HaroldHallikainen/DSP_TU_PCB/DSP_TU_BOM_C.xlsx

Source: | C:\Users\Harold_Win7\Documents\KiCad\DSP_TU\DSP_TU.kicad_sch
Date: | 2023-05-30 15:31
Tool: | Eeschema 7.0.5
Generator: | C:\Program Files\KiCad\6.0\bin\scripting\plugins/bom_csv_grouped_by_value_with_fp.py
Component Count: | 72 |  |  |  |  | Digikey |  | Mouser
Ref | Qnty | Value | Cmp name | Footprint | Description | p/n | Total Cost | p/n | Total Cost
C1, C2, C3, C4, C5, C6, C7, C8, C12, C13, C18, C22, C23, | 13 | 100nF | C | Capacitor_SMD:C_0603_1608Metric_Pad1.08x0.95mm_HandSolder, 50V X7R | 0.1 µF ±10% 50V Ceramic Capacitor X7R 0603 (1608 Metric) | 1276-1935-1-ND | $0.25 | 581-0603X7R104JT1AT | $5.66
C9, | 1 | 1nF | C | Capacitor_SMD:C_0603_1608Metric_Pad1.08x0.95mm_HandSolder | 1000 pF ±1% 50V Ceramic Capacitor C0G, NP0 0603 (1608 Metric) | 1292-1475-1-ND | $0.10 | 80-C0603C102F4G | $0.82
C10, C19, | 2 | 1uF | C | Capacitor_SMD:C_0603_1608Metric_Pad1.08x0.95mm_HandSolder | 1 µF ±10% 10V Ceramic Capacitor X7R 0603 (1608 Metric) | 1276-1946-1-ND | $0.20 | 581-0603X7R105KT7AT | $0.92
C11, | 1 | 100pF | C | Capacitor_SMD:C_0603_1608Metric_Pad1.08x0.95mm_HandSolder | 100 pF ±5% 50V Ceramic Capacitor C0G, NP0 0603 (1608 Metric) | 1292-1644-1-ND | $0.10 | 187-CL10C101JB8NNND | $0.10
C14, C15, | 2 | 47pF | C | Capacitor_SMD:C_0603_1608Metric_Pad1.08x0.95mm_HandSolder | 47 pF ±5% 50V Ceramic Capacitor C0G, NP0 0603 (1608 Metric) | 1292-1528-1-ND | $0.20 | 81-GRT0335C1E470GA2D | $0.20
C16, C21, | 2 | 10nF | C | Capacitor_SMD:C_0603_1608Metric_Pad1.08x0.95mm_HandSolder | 10000 pF ±10% 50V Ceramic Capacitor X7R 0603 (1608 Metric) | 1276-1009-1-ND | $0.20 | 581-06035C103K | $0.20
C17, | 1 | 4.7uF | C | Capacitor_SMD:C_0603_1608Metric_Pad1.08x0.95mm_HandSolder | 4.7 µF ±10% 10V Ceramic Capacitor X5R 0603 (1608 Metric) | 1276-1044-1-ND | $0.10 | 187-CL10A475KQ8NNNC | $0.10
C20, | 1 | 10uF | C | Capacitor_SMD:C_0603_1608Metric_Pad1.08x0.95mm_HandSolder | 10 µF ±20% 6.3V Ceramic Capacitor X5R 0603 (1608 Metric) | 1276-1119-1-ND | $0.11 | x
CR1, | 1 | BZW04-376BRL | BZW04-376BRL | HhLibrary:BZW04-376BRL | 603V Clamp 800mA Ipp Tvs Diode Through Hole DO-15 (DO-204AC) | 497-7737-1-ND | $0.59 | 511-BZW04-376B | $0.59
FB1, | 1 | MI0805K400R-10 | MI0805K400R-10 | HhLibrary:BEADC2012X110N | 40 Ohms @ 100 MHz 1 Power, Signal Line Ferrite Bead 0805 (2012 Metric) 2A 50mOhm | 240-2389-1-ND | $0.20 | 875-MI0805K400R-10 | $0.20
J1, | 1 | Conn_01x07_Male | Conn_01x07_Male | Connector_PinHeader_2.54mm:PinHeader_1x07_P2.54mm_Horizontal | Connector Header Through Hole, Right Angle 7 position 0.100" (2.54mm) | 2057-PH1RB-07-UA-ND | $0.24 | 649-1012937990701BLF | $0.22
 |  |  |  | Female 1x7 connector for display | 7 Position Header Connector 0.100" (2.54mm) Through Hole Tin | S7005-ND | $0.59 | 437-8018700710001101 | $0.89
J2,J4,J6,J7 | 4 | Conn_01x08_Male | Conn_01x08_Male | Connector_PinHeader_2.54mm:PinHeader_1x08_P2.54mm_Vertical | PIN HEADER, SINGLE ROW 8 PIN STR | 2553-2011-1X08TSB-ND | $0.08 | 649-1012937890801BLF | $0.19
J3, | 1 | USB_B | USB_B | HhLibrary:UJ2-BH-BL1-TH | USB-B (USB TYPE-B) USB 2.0 Receptacle Connector 4 Position Through Hole, Right Angle | 102-5886-ND | $0.70 | x490-UJ2-BH-BL1-TH | $0.78
J5, | 1 | 1757569 | 1757569 | HhLibrary:1757569 | 12 Position Terminal Block Header, Male Pins, Shrouded (4 Side) 0.197" (5.00mm) 90°, Right Angle Through Hole | 277-1127-ND | $4.90 | 651-1757569 | $4.90
 | 1 |  |  |  | 12 Position Terminal Block Plug, Female Sockets 0.197" (5.00mm) 180° Free Hanging (In-Line) | 277-1010-ND | $13.15 | 651-1754643 | $12.15
K1, K2, | 2 | G3VM-601BY | G3VM-601BY | Package_DIP:DIP-6_W7.62mm | Solid State SPST-NO (1 Form A) 6-DIP (0.300", 7.62mm) | Z1040-ND | $12.68 | 653-G3VM-601BY | $12.68
Socket for K1, K2 | 2 |  |  |  | 6 (2 x 3) Pos DIP, 0.3" (7.62mm) Row Spacing Socket Tin Through Hole | 2057-ICS-306-T-ND | $0.34 | 571-1-2199298-1 | $0.52
R1,R2,R3,R10,R20 | 5 | 10k | R | Resistor_SMD:R_0603_1608Metric_Pad0.98x0.95mm_HandSolder | 10 kOhms ±1% 0.125W, 1/8W Chip Resistor 0603 (1608 Metric) Anti-Sulfur Thin Film | RNCP0603FTD10K0CT-ND | $0.40 | 667-ERJ-3GEYJ103V | $0.40
R4, | 1 | 30k | R | Resistor_SMD:R_0603_1608Metric_Pad0.98x0.95mm_HandSolder | 30 kOhms ±5% 0.1W, 1/10W Chip Resistor 0603 (1608 Metric) Moisture Resistant Thick Film | 311-30KGRCT-ND | $0.10 | 71-CRCW060330K0FKEAC | $0.10
R5, | 1 | 510k | R | Resistor_SMD:R_0603_1608Metric_Pad0.98x0.95mm_HandSolder | 510 kOhms ±5% 0.1W, 1/10W Chip Resistor 0603 (1608 Metric) Moisture Resistant Thick Film | 311-510KGRCT-ND | $0.10 | 71-CRCW0603J-510K-E3 | $0.10
R6, R7, | 2 | 27 | R | Resistor_SMD:R_0603_1608Metric_Pad0.98x0.95mm_HandSolder | 27 Ohms ±1% 0.1W, 1/10W Chip Resistor 0603 (1608 Metric) Thick Film | 13-RC0603FR-1327RLCT-ND | $0.20 | 667-ERJ-3EKF27R0V | $0.20
R8, R9, R22, R23, R24, R25, R26, R27, | 8 | 220 | R | Resistor_SMD:R_0603_1608Metric_Pad0.98x0.95mm_HandSolder | 220 Ohms ±5% 0.1W, 1/10W Chip Resistor 0603 (1608 Metric) Automotive AEC-Q200, Moisture Resistant Thick Film | A130087CT-ND | $0.80 | 652-CR0603FX-2200ELF | $0.80
R11, | 1 | 39 | R | Resistor_SMD:R_0603_1608Metric_Pad0.98x0.95mm_HandSolder | 39 Ohms ±5% 0.1W, 1/10W Chip Resistor 0603 (1608 Metric) Moisture Resistant Thick Film | 311-39GRCT-ND | $0.10 | 603-RC0603JR-0739RP | $0.10
R12, R17, | 2 | 1M | R | Resistor_SMD:R_0603_1608Metric_Pad0.98x0.95mm_HandSolder | 1 MOhms ±5% 0.1W, 1/10W Chip Resistor 0603 (1608 Metric) Automotive AEC-Q200, Moisture Resistant Thick Film | A130109CT-ND | $0.20 | 791-WR06X105JTL | $0.20
R13, R14, R15, R16, | 4 | 33 | R | Resistor_SMD:R_0603_1608Metric_Pad0.98x0.95mm_HandSolder | 33 Ohms ±1% 0.1W, 1/10W Chip Resistor 0603 (1608 Metric) Moisture Resistant Thick Film | 13-RC0603FR-0733RLCT-ND | $0.40 | 71-CRCW060333R0JNEAC | $0.40
R18,R19,R21 | 3 | 1k | R | Resistor_SMD:R_0603_1608Metric_Pad0.98x0.95mm_HandSolder | 1k Ohms ±1% 0.1W, 1/10W Chip Resistor 0603 (1608 Metric) Moisture Resistant Thick Film | 311-1.00KHRCT-ND | $0.10
S1, S2, S3, S4, S5, S6, | 6 | 228DD1S1AAFAMSC | 228DD1S1AAFAMSC_3 | 228DD1S1AAFAMSC | Tactile Switch SPST-NO Side Actuated Through Hole, Right Angle | 119-228DD1S1AAFAMSC-ND | $12.66 | 774-228DD1S1AAFAMSC | $12.54
S7, | 1 | PEC12R-2220F-S0024 | PEC12R-2220F-S0024 | XDCR_PEC12R-2220F-S0024 | Rotary Encoder Mechanical 24 Quadrature (Incremental) Right Angle | PEC12R-2220F-S0024-ND | $1.62 | 652-PEC12R2220FS0024 | $1.65
S8, | 1 | 100DP1T2B4M7QE | 100DP1T2B4M7QE | 100DP1T2B4M7QE_EWI | Toggle Switch DPDT Through Hole, Right Angle, Vertical | 100DP1T2B4M7QE-ND | $3.13 | 612-100DP1T2B4M7QE | $5.02
T1, | 1 | TY-141P | TY-141P | HhLibrary:DIPS1067W107P475L2062H1880Q6N | 10kCT Impedance Primary Ohms 10kCT Impedance Secondary Ohms 1:1 Audio Transformer 200Hz ~ 15kHz Through Hole | 237-1118-ND | $6.36 | 553-TY141P | $5.69
T2, | 1 | TY-145P | TY-145P | HhLibrary:DIPS1067W107P475L2062H1880Q6N | 600CT Impedance Primary Ohms 600CT Impedance Secondary Ohms 1:1 Audio Transformer 200Hz ~ 15kHz Through Hole | 237-1121-ND | $6.36 | 553-TY145P | $6.30
U1, | 1 | PIC32MZ0512EFE064-I_PT | PIC32MZ0512EFE064-I_PT | HhLibrary:QFP50P1200X1200X120-64N | MIPS32® M-Class PIC® 32MZ Microcontroller IC 32-Bit Single-Core 200MHz 512KB (512K x 8) FLASH 64-TQFP (10x10) | PIC32MZ0512EFE064-I/PT-ND | $11.28 | 579-MZ0512EFE064IPT | $10.74
U2, | 1 | TLV2780CDBVT | TLV2780CDBVT | HhLibrary:SOT95P280X145-6N | General Purpose Amplifier 1 Circuit Rail-to-Rail SOT-23-6 | 296-32385-1-ND | $2.74 | 595-TLV2780CDBVT | $2.81
U3, | 1 | FT231XS-U | FT231XS-U | Package_SO:SSOP-20_5.3x7.2mm_P0.65mm | USB Bridge, USB to UART USB 2.0 UART Interface 20-SSOP | 768-1156-5-ND | $2.34 | 895-FT231XS-R | $2.34
U4, | 1 | H11AA1 | H11AA1 | Package_DIP:DIP-6_W7.62mm | Optoisolator Transistor with Base Output 5300Vrms 1 Channel 6-DIP | 751-1276-5-ND | $1.33 | 782-H11AA1 | $1.33
U5, | 1 | 74HCT2G14GW-Q100H | 74HCT2G14GW-Q100H | HhLibrary:74HCT2G14GWQ100H | Inverter IC 2 Channel Schmitt Trigger 6-TSSOP | 1727-1179-1-ND | $0.52 | 771-74HCT2G14GWQ100H | $0.53
U6, | 1 | AP2112K-3.3 | AP2112K-3.3 | Package_TO_SOT_SMD:SOT-23-5 | 600mA low dropout linear regulator, with enable pin, 3.8V-6V input voltage range, 3.3V fixed positive output, SOT-23-5 | AP2112K-3.3TRG1DICT-ND | $0.35 | 621-AP2112K-3.3TRG1 | $0.37
U7, | 1 | ATWINC1510-MR210UB | ATWINC1510-MR210UB | HhLibrary:ATWINC1510MR210UB | WiFi 802.11b/g/n Transceiver Module 2.4GHz Antenna Not Included, U.FL Surface Mount | ATWINC1510-MR210UB-ND | $11.28 | 556-1510MR210UB1140 | $9.62
U8, | 1 | W25X40CLSN | W25X40CLSN | Package_SO:SOIC-8_3.9x4.9mm_P1.27mm | 4Mbit Serial Flash memory, dual I/O SPI, SOIC-8 | W25X40CLSNIG-ND | $0.42 | 454-W25X40CLSNIG | $0.42
Enclosure | 1 | Heyiarbeit DFC3500GP0402 |  | https://www.amazon.com/dp/B08X6QQNNX | Enclosure |  |  |  | 9.99
 |  |  |  |  | RF Cable Assemblies RP-SMA Gold Jack (Female) Bulkhead (CONREVSMA005B-G-1.13) to Right Angle MHF/U.FL Compatible Jack (CONUFL012-1.13) with 100mm of 1.13mm Cable | CSI-RGFB-100-UFFR-ND | $5.19 | 712-CSI-RGFB-1-UFFR | $5.19
Display | 1 | Waveshare SKU 14747. (https://www.waveshare.com/1.5inch-rgb-oled-module.htm) |  | https://www.waveshare.com/1.5inch-rgb-oled-module.htm or https://www.aliexpress.us/item/2255799949791867.html?gatewayAdapt=glo2usa
Total |  |  |  |  |  |  | $102.71 |  | $117.96
