HaroldHallikainen/DSP_TU_PCB/DspTuScehmaticRevC.pdf

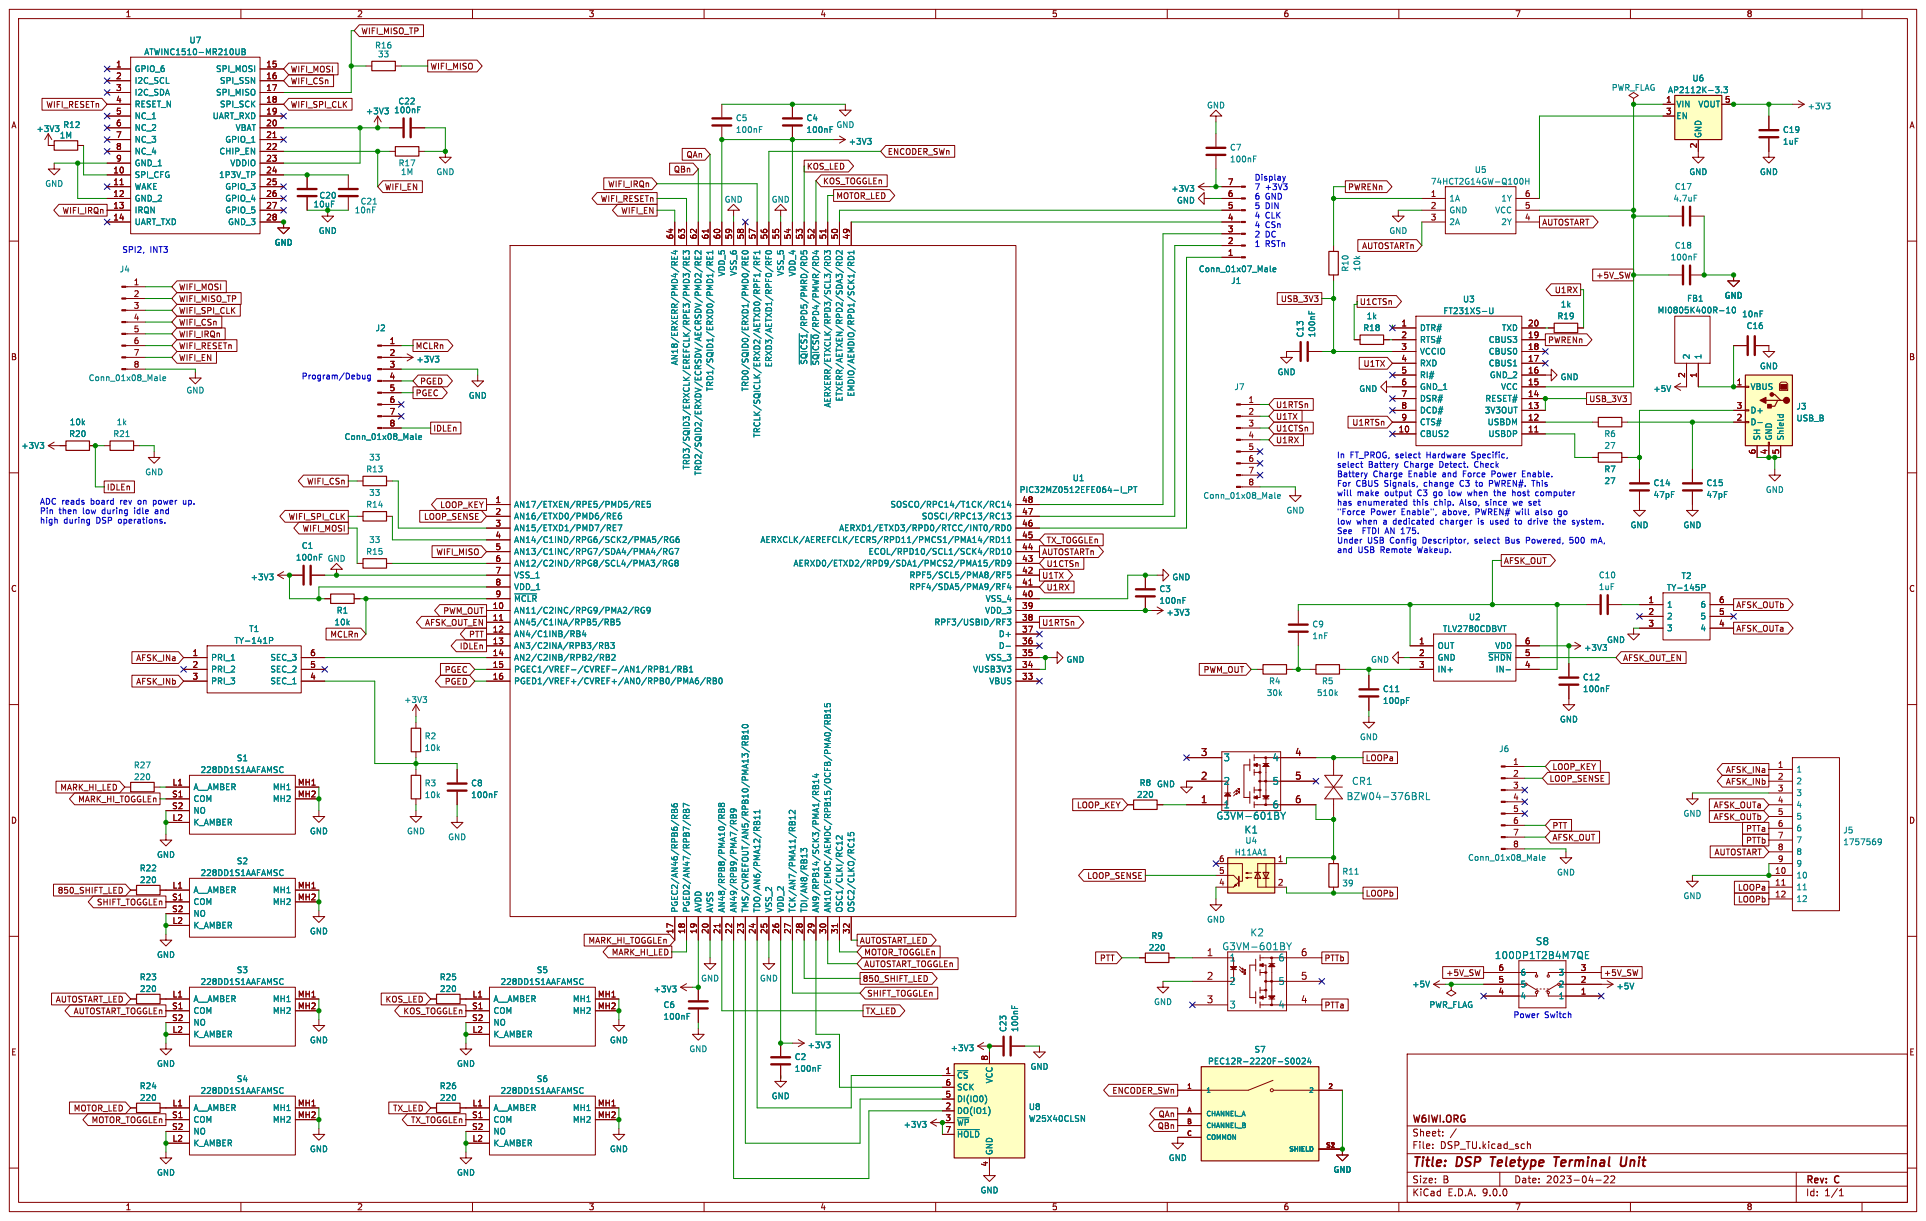
[picture p1: page 1]

Program/Debug ADC reads board rev on power up. Pin then low during idle and

LOOPb AFSK_OUTb PTTb PTTa AUTOSTART

Id: 1/1 Title: DSP Teletype Terminal Unit File: DSP_TU.kicad_sch Sheet: / W6IWI.ORG
