HaroldHallikainen/DSP_TU_PCB/DspTuSchematicRevB.pdf

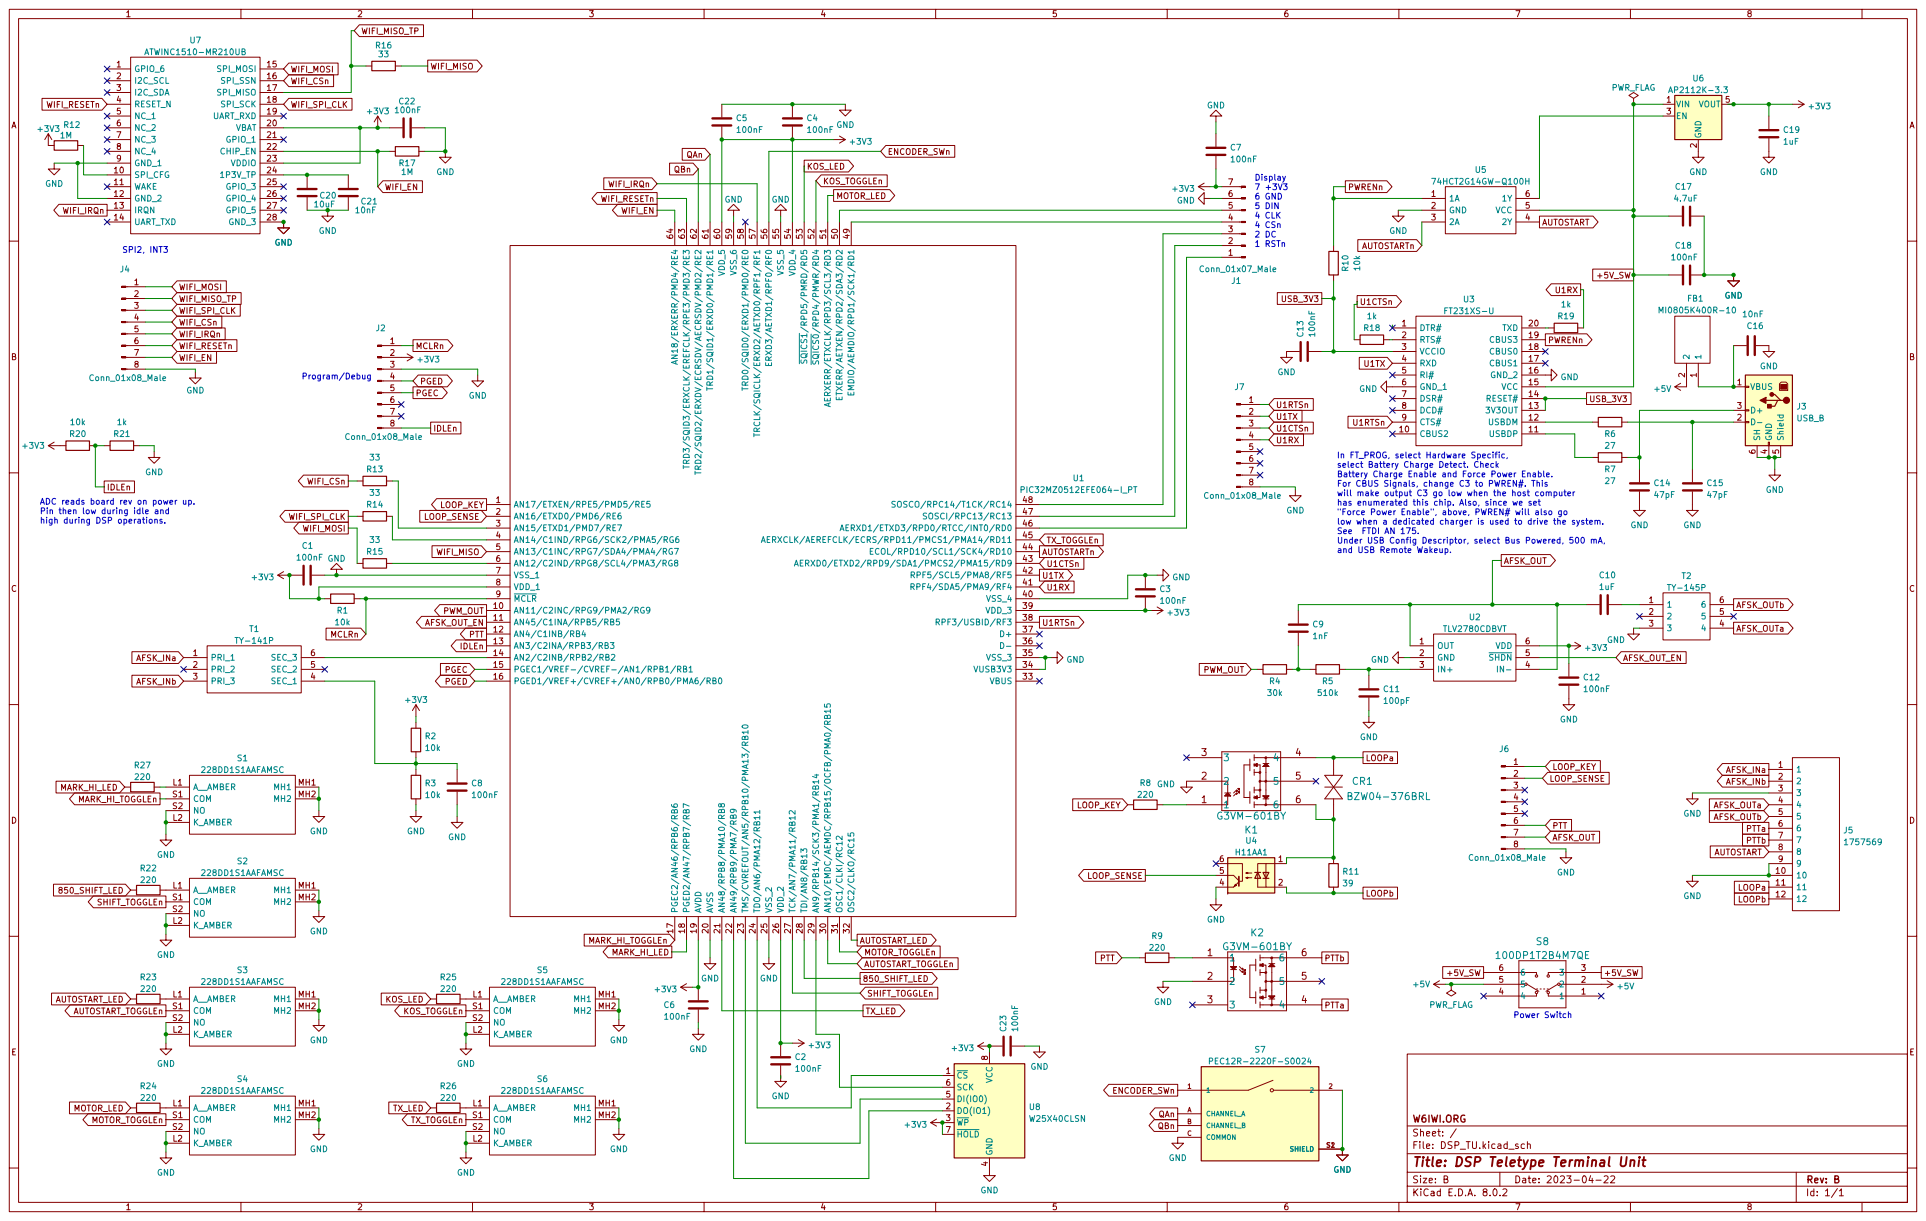
[picture p2: page 1]
