HaroldHallikainen/DSP_TU_PCB/DSP_TU.kicad_pcb

## KiCad design DSP_TU.kicad_pcb (2025-07-10)

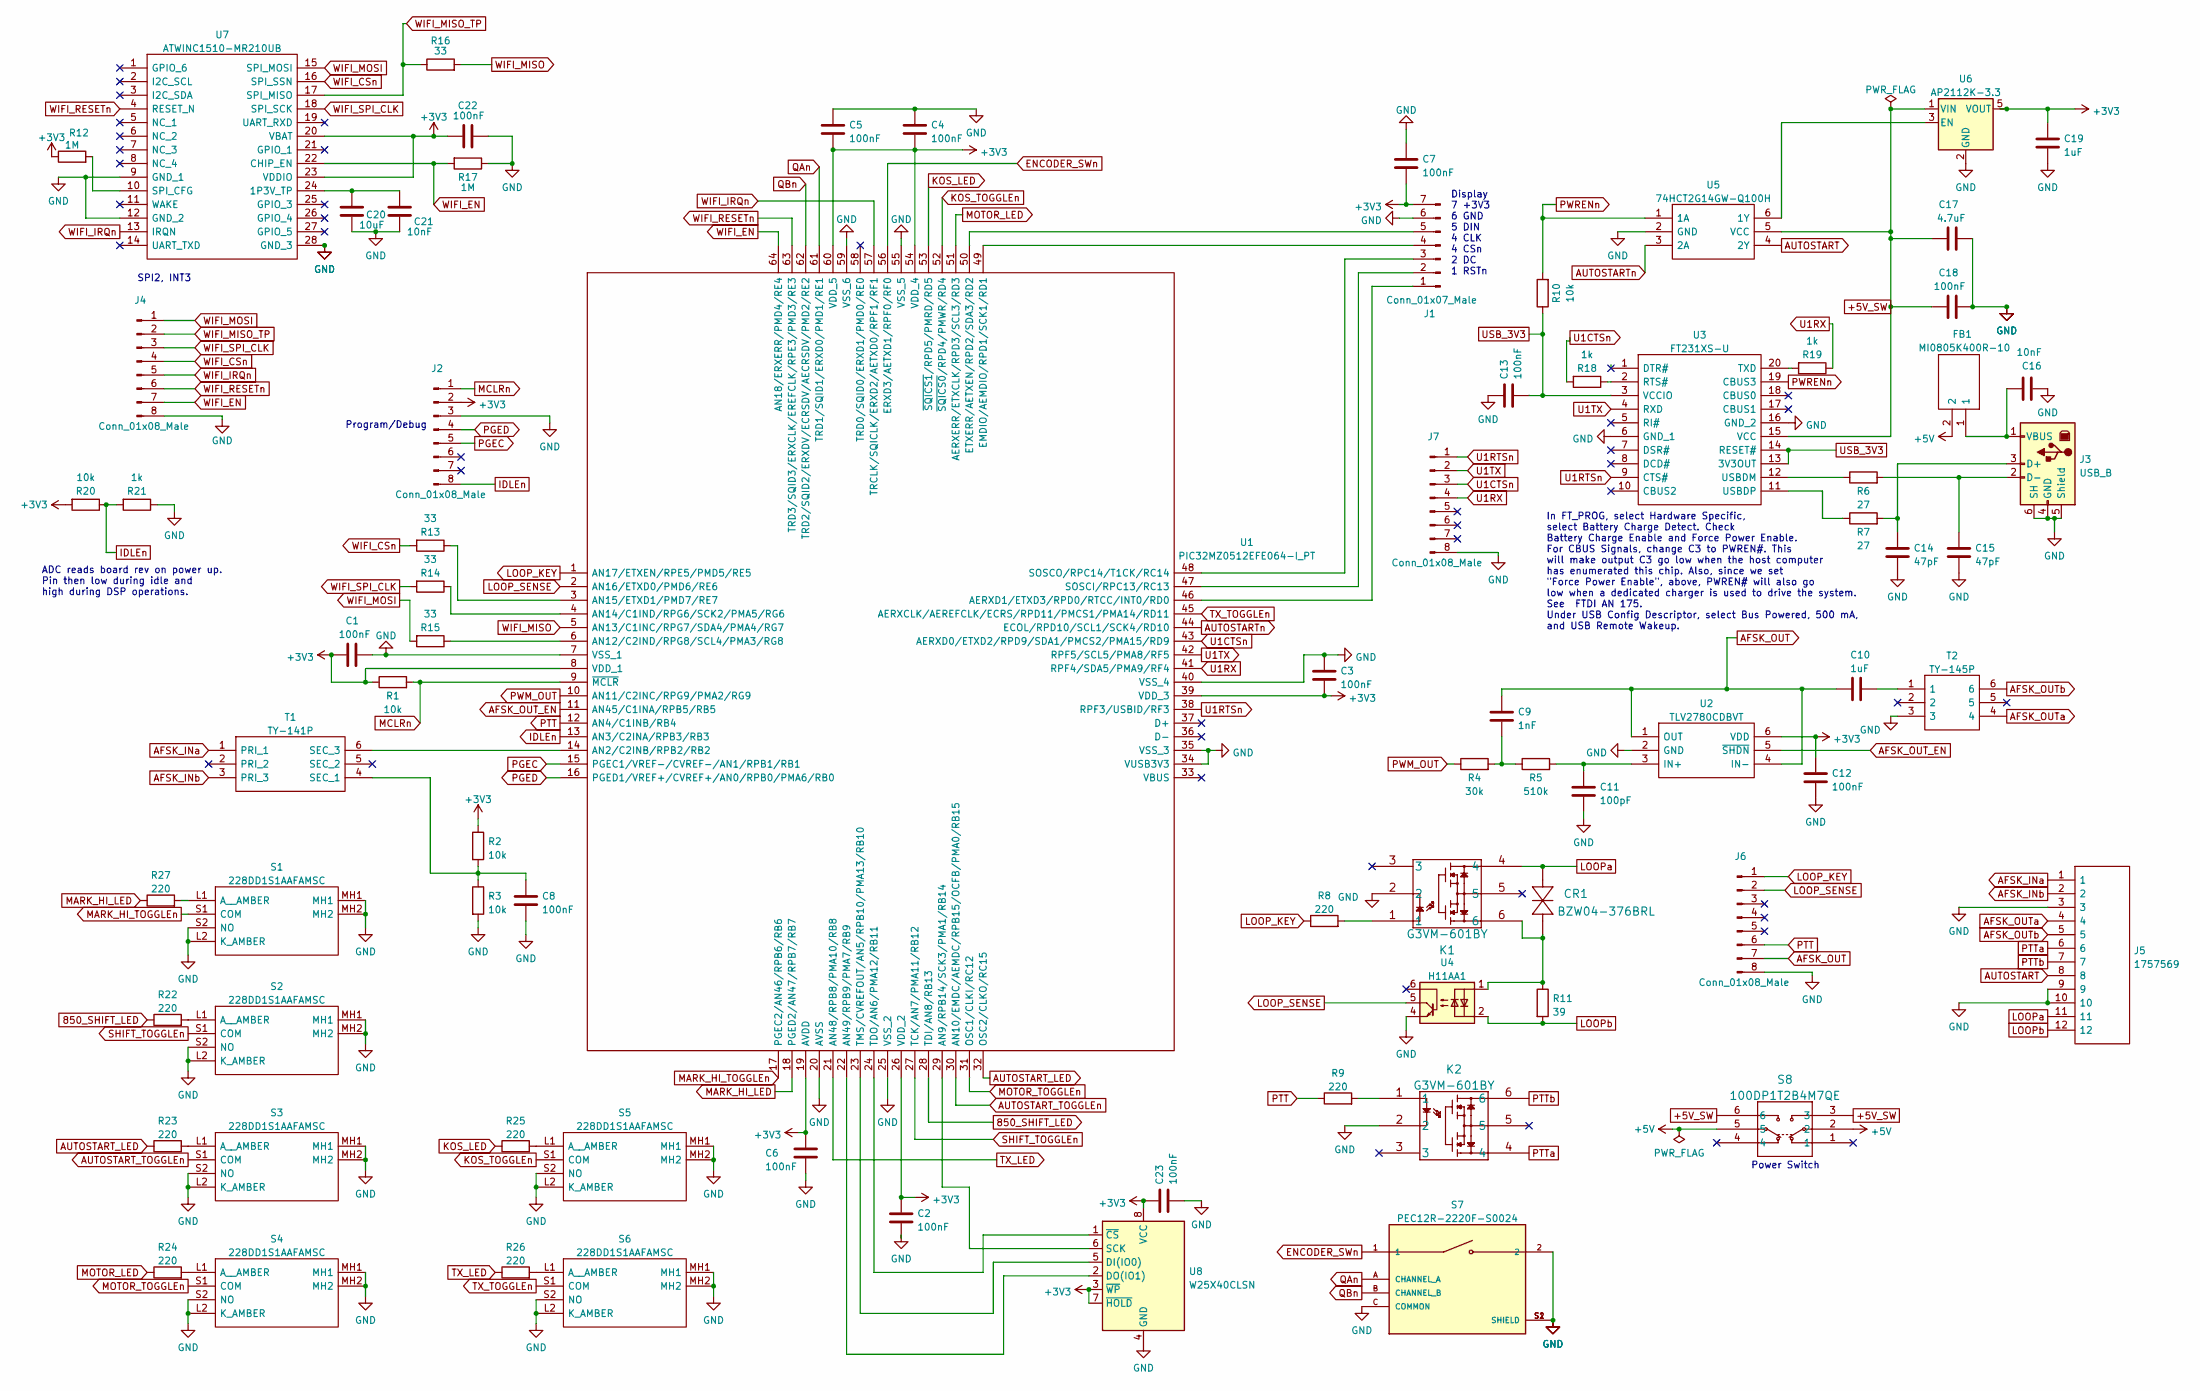
[picture p3: schematic DSP_TU.kicad_sch, DSP Teletype Terminal Unit]

Parts:
C1, C2, C3, C4, C5, C6, C7, C8, C12, C13, C18, C22, C23: 100nF; C_0603_1608Metric_Pad1.08x0.95mm_HandSolder
C9: 1nF; C_0603_1608Metric_Pad1.08x0.95mm_HandSolder
C10, C19: 1uF; C_0603_1608Metric_Pad1.08x0.95mm_HandSolder
C11: 100pF; C_0603_1608Metric_Pad1.08x0.95mm_HandSolder
C14, C15: 47pF; C_0603_1608Metric_Pad1.08x0.95mm_HandSolder
C16, C21: 10nF; C_0603_1608Metric_Pad1.08x0.95mm_HandSolder
C17: 4.7uF; C_0603_1608Metric_Pad1.08x0.95mm_HandSolder
C20: 10uF; C_0603_1608Metric_Pad1.08x0.95mm_HandSolder
CR1: BZW04-376BRL
FB1: MI0805K400R-10; BEADC2012X110N; Manufacturer_Part_Number MI0805K400R-10; Mouser Part Number 875-MI0805K400R-10
J1: Conn_01x07_Male; PinHeader_1x07_P2.54mm_Horizontal
J2, J4, J6, J7: Conn_01x08_Male; PinHeader_1x08_P2.54mm_Vertical
J3: USB_B; UJ2-BH-BL1-TH
J5: 1757569; Manufacturer_Part_Number 1757569; Mouser Part Number 651-1757569
K1, K2: G3VM-601BY; DIP-6_W7.62mm
R1, R2, R3, R10, R20: 10k; R_0603_1608Metric_Pad0.98x0.95mm_HandSolder
R4: 30k; R_0603_1608Metric_Pad0.98x0.95mm_HandSolder
R5: 510k; R_0603_1608Metric_Pad0.98x0.95mm_HandSolder
R6, R7: 27; R_0603_1608Metric_Pad0.98x0.95mm_HandSolder
R8, R9, R22, R23, R24, R25, R26, R27: 220; R_0603_1608Metric_Pad0.98x0.95mm_HandSolder
R11: 39; R_0603_1608Metric_Pad0.98x0.95mm_HandSolder
R12, R17: 1M; R_0603_1608Metric_Pad0.98x0.95mm_HandSolder
R13, R14, R15, R16: 33; R_0603_1608Metric_Pad0.98x0.95mm_HandSolder
R18, R19, R21: 1k; R_0603_1608Metric_Pad0.98x0.95mm_HandSolder
S1, S2, S3, S4, S5, S6: 228DD1S1AAFAMSC; Manufacturer_Part_Number 228DD1S1AAFAMSC; Mouser Part Number 774-228DD1S1AAFAMSC
S7: PEC12R-2220F-S0024; XDCR_PEC12R-2220F-S0024; PARTREV 07/21
S8: 100DP1T2B4M7QE; 100DP1T2B4M7QE_EWI
T1: TY-141P; DIPS1067W107P475L2062H1880Q6N; Manufacturer_Part_Number TY-141P; Mouser Part Number 553-TY141P
T2: TY-145P; DIPS1067W107P475L2062H1880Q6N; Manufacturer_Part_Number TY-145P; Mouser Part Number 553-TY145P
U1: PIC32MZ0512EFE064-I_PT; QFP50P1200X1200X120-64N; Manufacturer_Part_Number PIC32MZ0512EFE064-I/PT; Mouser Part Number 579-MZ0512EFE064IPT
U2: TLV2780CDBVT; SOT95P280X145-6N; Manufacturer_Part_Number TLV2780CDBVT; Mouser Part Number 595-TLV2780CDBVT
U3: FT231XS-U; SSOP-20_5.3x7.2mm_P0.65mm; Manufacturer_Part_Number FT231XS-U; Mouser Part Number 895-FT231XS-U
U4: H11AA1; DIP-6_W7.62mm
U5: 74HCT2G14GW-Q100H; 74HCT2G14GWQ100H; Manufacturer_Part_Number 74HCT2G14GW-Q100H; Mouser Part Number 771-74HCT2G14GWQ100H
U6: AP2112K-3.3; SOT-23-5
U7: ATWINC1510-MR210UB; ATWINC1510MR210UB; Mouser Part Number 556-ATWINC1510MR210U
U8: W25X40CLSN; SOIC-8_3.9x4.9mm_P1.27mm

Connections:
850_SHIFT_LED: R22.1, U1.28 (TDI/AN8/RB13)
+3V3: C1.2, C2.1, C3.2, C4.2, C5.2, C6.1, C7.2, C12.1, C19.1, C22.1, C23.1, J1.7, J2.2, R1.1, R2.1, R12.1, R20.2, U1.8 (VDD_1), U1.19 (AVDD), U1.26 (VDD_2), U1.39 (VDD_3), U1.54 (VDD_4), U1.60 (VDD_5), U2.6 (VDD), U6.5 (VOUT), U7.20 (VBAT), U7.23 (VDDIO), U8.3 (~WP), U8.7 (~HOLD), U8.8 (VCC)
+5V: FB1.2, S8.2, S8.5
+5V_SW: C17.1, C18.1, S8.3, S8.6, U3.15 (VCC), U5.5 (VCC), U6.1 (VIN)
AFSK_INa: J5.1, T1.1 (PRI_1)
AFSK_INb: J5.2, T1.3 (PRI_3)
AFSK_OUT: C9.1, C10.2, J6.7, U2.1 (OUT), U2.4 (IN-)
AFSK_OUT_EN: U1.11 (AN45/C1INA/RPB5/RB5), U2.5 (~SHDN)
AFSK_OUTa: J5.4, T2.4
AFSK_OUTb: J5.5, T2.6
AUTOSTART: J5.8, U5.4 (2Y)
AUTOSTART_LED: R23.1, U1.32 (OSC2/CLKO/RC15)
AUTOSTART_TOGGLEn: S3.S1 (COM), U1.30 (AN10/EMDC/AEMDC/RPB15/OCFB/PMA0/RB15)
AUTOSTARTn: U1.44 (ECOL/RPD10/SCL1/SCK4/RD10), U5.3 (2A)
ENCODER_SWn: S7.1, U1.56 (ERXD3/AETXD1/RPF0/RF0)
GND: C1.1, C2.2, C3.1, C4.1, C5.1, C6.2, C7.1, C8.2, C11.2, C12.2, C13.1, C14.2, C15.2, C16.2, C17.2, C18.2, C19.2, C20.2, C21.2, C22.2, C23.2, J1.6, J2.3, J3.4 (GND), J3.5 (Shield), J3.6 (SH), J4.8, J5.3, J5.9, J5.10, J6.8, J7.8, K1.2, K2.2, R3.2, R17.1, R21.1, S1.L2 (K_AMBER), S1.MH1, S1.MH2, S1.S2 (NO), S2.L2 (K_AMBER), S2.MH1, S2.MH2, S2.S2 (NO), S3.L2 (K_AMBER), S3.MH1, S3.MH2, S3.S2 (NO), S4.L2 (K_AMBER), S4.MH1, S4.MH2, S4.S2 (NO), S5.L2 (K_AMBER), S5.MH1, S5.MH2, S5.S2 (NO), S6.L2 (K_AMBER), S6.MH1, S6.MH2, S6.S2 (NO), S7.2, S7.C (COMMON), S7.S1 (SHIELD), S7.S2 (SHIELD), T2.3, U1.7 (VSS_1), U1.20 (AVSS), U1.25 (VSS_2), U1.34 (VUSB3V3), U1.35 (VSS_3), U1.40 (VSS_4), U1.55 (VSS_5), U1.59 (VSS_6), U2.2 (GND), U3.6 (GND_1), U3.16 (GND_2), U4.4, U5.2 (GND), U6.2 (GND), U7.9 (GND_1), U7.12 (GND_2), U7.28 (GND_3), U8.4 (GND)
IDLEn: J2.8, R20.1, R21.2, U1.13 (AN3/C2INA/RPB3/RB3)
KOS_LED: R25.1, U1.53 (~SQICS1/RPD5/PMRD/RD5)
KOS_TOGGLEn: S5.S1 (COM), U1.52 (~SQICS0/RPD4/PMWR/RD4)
LOOP_KEY: J6.1, R8.1, U1.1 (AN17/ETXEN/RPE5/PMD5/RE5)
LOOP_SENSE: J6.2, U1.2 (AN16/ETXD0/PMD6/RE6), U4.5
LOOPa: CR1.1 (CATHODE/ANODE), J5.11, K1.4
LOOPb: J5.12, R11.2, U4.2
MARK_HI_LED: R27.1, U1.18 (PGED2/AN47/RPB7/RB7)
MARK_HI_TOGGLEn: S1.S1 (COM), U1.17 (PGEC2/AN46/RPB6/RB6)
MCLRn: J2.1, R1.2, U1.9 (~MCLR)
MOTOR_LED: R24.1, U1.51 (AERXERR/ETXCLK/RPD3/SCL3/RD3)
MOTOR_TOGGLEn: S4.S1 (COM), U1.31 (OSC1/CLKI/RC12)
unnamed: C9.2, R4.2, R5.1
unnamed: C10.1, T2.1
unnamed: CR1.2 (CATHODE/ANODE), K1.6, R11.1, U4.1
unnamed: J1.1, U1.46 (AERXD1/ETXD3/RPD0/RTCC/INT0/RD0)
unnamed: J1.2, U1.47 (SOSCI/RPC13/RC13)
unnamed: J1.3, U1.48 (SOSCO/RPC14/T1CK/RC14)
unnamed: J1.4, U1.49 (EMDIO/AEMDIO/RPD1/SCK1/RD1)
unnamed: J1.5, U1.50 (ETXERR/AETXEN/RPD2/SDA3/RD2)
unnamed: C14.1, J3.3 (D+), R7.2
unnamed: C15.1, J3.2 (D-), R6.2
unnamed: C16.1, FB1.1, J3.1 (VBUS)
unnamed: K1.1, R8.2
unnamed: K2.1, R9.2
unnamed: R27.2, S1.L1 (A__AMBER)
unnamed: R22.2, S2.L1 (A__AMBER)
unnamed: R23.2, S3.L1 (A__AMBER)
unnamed: R24.2, S4.L1 (A__AMBER)
unnamed: R25.2, S5.L1 (A__AMBER)
unnamed: R26.2, S6.L1 (A__AMBER)
unnamed: C8.1, R2.2, R3.1, T1.4 (SEC_1)
unnamed: T1.6 (SEC_3), U1.14 (AN2/C2INB/RPB2/RB2)
unnamed: U1.29 (AN9/RPB14/SCK3/PMA1/RB14), U8.6 (SCK)
unnamed: R15.1, U1.6 (AN12/C2IND/RPG8/SCL4/PMA3/RG8)
unnamed: R14.1, U1.4 (AN14/C1IND/RPG6/SCK2/PMA5/RG6)
unnamed: R13.1, U1.3 (AN15/ETXD1/PMD7/RE7)
unnamed: U1.22 (AN49/RPB9/PMA7/RB9), U8.2 (DO(IO1))
unnamed: U1.24 (TDO/AN6/PMA12/RB11), U8.1 (~CS)
unnamed: U1.23 (TMS/CVREFOUT/AN5/RPB10/PMA13/RB10), U8.5 (DI(IO0))
unnamed: C11.1, R5.2, U2.3 (IN+)
unnamed: R18.1, U3.2 (RTS#)
unnamed: R19.2, U3.20 (TXD)
unnamed: R6.1, U3.12 (USBDM)
unnamed: R7.1, U3.11 (USBDP)
unnamed: U5.6 (1Y), U6.3 (EN)
unnamed: C20.1, C21.1, U7.24 (1P3V_TP)
unnamed: R12.2, U7.10 (SPI_CFG)
PGEC: J2.5, U1.15 (PGEC1/VREF-/CVREF-/AN1/RPB1/RB1)
PGED: J2.4, U1.16 (PGED1/VREF+/CVREF+/AN0/RPB0/PMA6/RB0)
PTT: J6.6, R9.1, U1.12 (AN4/C1INB/RB4)
PTTa: J5.6, K2.4
PTTb: J5.7, K2.6
PWM_OUT: R4.1, U1.10 (AN11/C2INC/RPG9/PMA2/RG9)
PWRENn: R10.2, U3.19 (CBUS3), U5.1 (1A)
QAn: S7.A (CHANNEL_A), U1.61 (TRD1/SQID1/ERXD0/PMD1/RE1)
QBn: S7.B (CHANNEL_B), U1.62 (TRD2/SQID2/ERXDV/ECRSDV/AECRSDV/PMD2/RE2)
SHIFT_TOGGLEn: S2.S1 (COM), U1.27 (TCK/AN7/PMA11/RB12)
TX_LED: R26.1, U1.21 (AN48/RPB8/PMA10/RB8)
TX_TOGGLEn: S6.S1 (COM), U1.45 (AERXCLK/AEREFCLK/ECRS/RPD11/PMCS1/PMA14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)
U1CTSn: J7.3, R18.2, U1.43 (AERXD0/ETXD2/RPD9/SDA1/PMCS2/PMA15/RD9)
U1RTSn: J7.1, U1.38 (RPF3/USBID/RF3), U3.9 (CTS#)
U1RX: J7.4, R19.1, U1.41 (RPF4/SDA5/PMA9/RF4)
U1TX: J7.2, U1.42 (RPF5/SCL5/PMA8/RF5), U3.4 (RXD)
USB_3V3: C13.2, R10.1, U3.3 (VCCIO), U3.13 (3V3OUT), U3.14 (RESET#)
WIFI_CSn: J4.4, R13.2, U7.16 (SPI_SSN)
WIFI_EN: J4.7, R17.2, U1.64 (AN18/ERXERR/PMD4/RE4), U7.22 (CHIP_EN)
WIFI_IRQn: J4.5, U1.57 (TRCLK/SQICLK/ERXD2/AETXD0/RPF1/RF1), U7.13 (IRQN)
WIFI_MISO: R16.2, U1.5 (AN13/C1INC/RPG7/SDA4/PMA4/RG7)
WIFI_MISO_TP: J4.2, R16.1, U7.17 (SPI_MISO)
WIFI_MOSI: J4.1, R15.2, U7.15 (SPI_MOSI)
WIFI_RESETn: J4.6, U1.63 (TRD3/SQID3/ERXCLK/EREFCLK/RPE3/PMD3/RE3), U7.4 (RESET_N)
WIFI_SPI_CLK: J4.3, R14.2, U7.18 (SPI_SCK)

Notes on the sheet:
Power Switch
SPI2, INT3
In FT_PROG, select Hardware Specific, select Battery Charge Detect. Check Battery Charge Enable and Force Power Enable. For CBUS Signals, change C3 to PWREN#. This will make output C3 go low when the host computer has enumerated this chip. Also, since we set "Force Power Enable", above, PWREN# will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
Display 7 +3V3 6 GND 5 DIN 4 CLK 4 CSn 2 DC 1 RSTn
ADC reads board rev on power up. Pin then low during idle and high during DSP operations.
Program/Debug

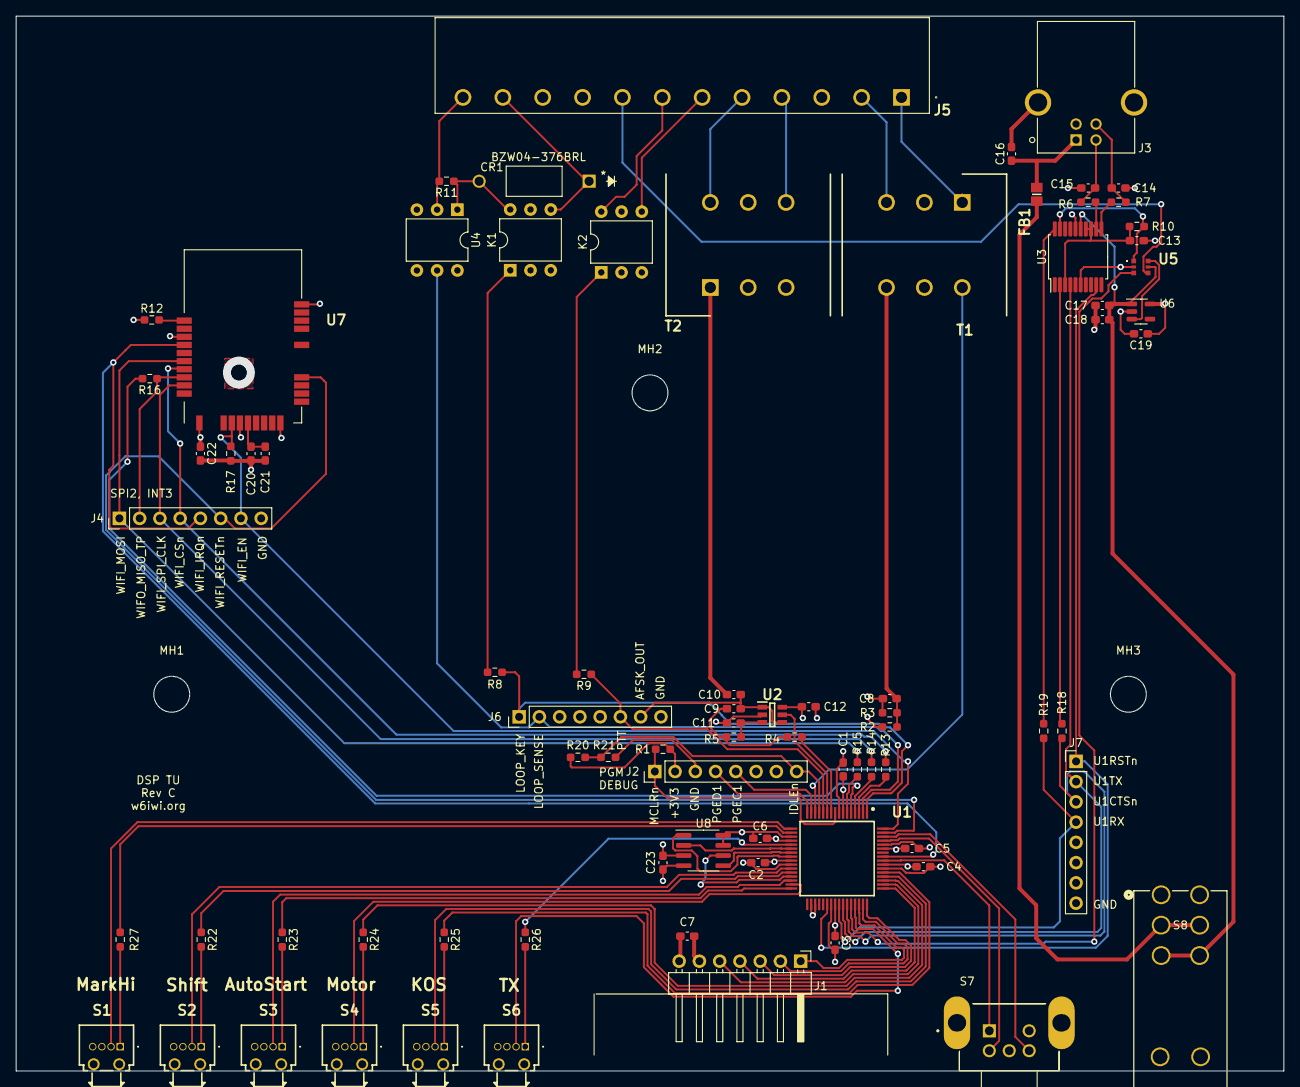
[picture p4: board DSP_TU.kicad_pcb from above]

Board: 4 copper layers, 159.0 x 132.3 mm, 82 parts (0 on the bottom side), 89 nets.

Other parts of the board:
MH1, MH2, MH3: MountingHole_4.5mm
