HaroldHallikainen/DSP_TU_PCB/(threads)

Thread 2 (2024-01-30):

Display connector backwards

HaroldHallikainen, 2024-01-30:
Swap pin numbers end to end on PCB footprint so display can plug in vertically above the board.

Thread 8 (2024-03-19):

Add PCB revision resistor

HaroldHallikainen, 2024-03-19:
Change AN3 from IDLE to PCB version voltage (voltage divider). Make RE0 idle.

HaroldHallikainen, 2024-05-25:
Made AN3 double as rev resistor and idlen. Read resistor on power up, then switch to idle indication.
