HaroldHallikainen/DSP_TU_PCB/(commit log)

2023-09-10 PCB rev A
    [DSP_TU-B_Cu.gbl, DSP_TU-B_Mask.gbs, DSP_TU-Edge_Cuts.gko, DSP_TU-F_Cu.gtl, DSP_TU-F_Mask.gts, DSP_TU-F_Silkscreen.gto, DSP_TU-NPTH-drl_map.gbr, DSP_TU-NPTH.drl]
2024-07-12 PCB Rev B, changing dimensions, adding test points, adding resistors in UART lines, and correcting display pinout. hh
    [DSP_TU-B_Cu.gbl, DSP_TU-B_Mask.gbs, DSP_TU-F_Cu.gtl, DSP_TU-F_Mask.gts, DSP_TU-F_Silkscreen.gto, DSP_TU-NPTH-drl_map.gbr, DSP_TU-NPTH.drl, DSP_TU-PTH-drl_map.gbr]
2024-07-12 PCB rev B
    [DPS_TU_BOM_B.csv, DSP_TU_BOM_A.csv, DSP_TU_BOM_A.xlsx, DSP_TU_BOM_B.xlsx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]
2024-07-12 Added rev B schematic PDF
2025-07-10 Update all to rev C
    [DSP_TU.kicad_pcb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]
